cliffbraun/BarBuddy/data_analysis/curl orientation.png

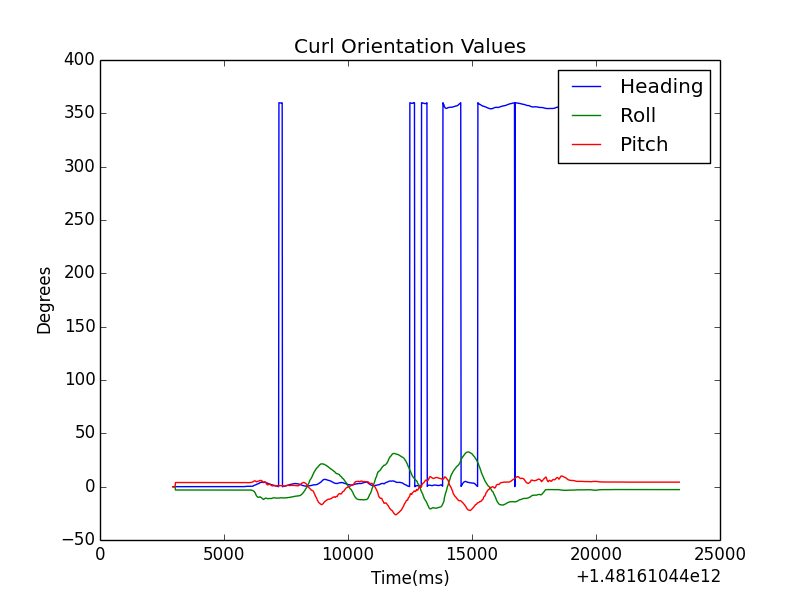
data_analysis/curl orientation.png
