cliffbraun/BarBuddy/data_analysis/curl orientation_trimmed.png

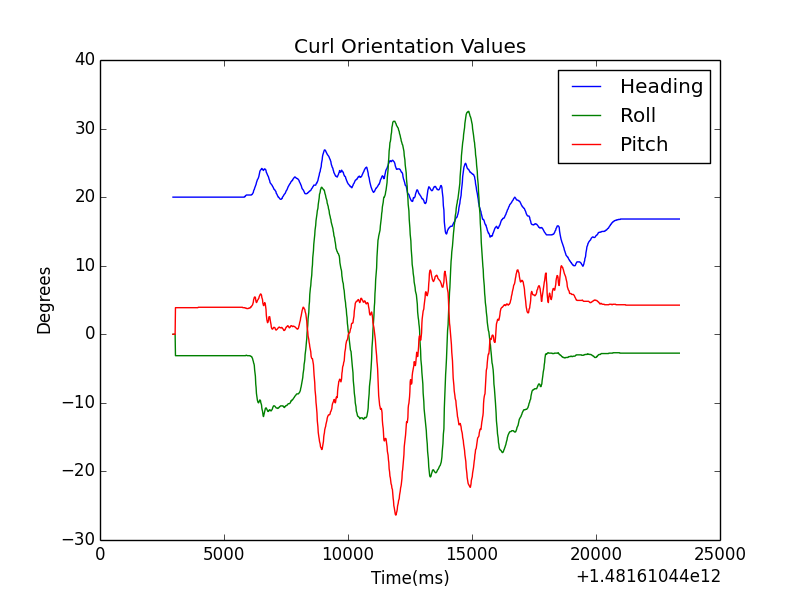
data_analysis/curl orientation_trimmed.png
