cliffbraun/BarBuddy/data_analysis/toomuchdata.png

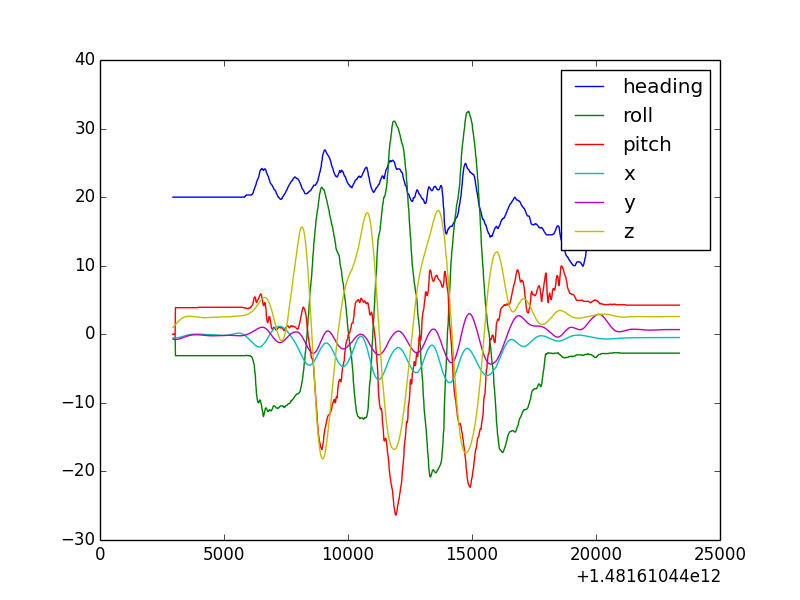
data_analysis/toomuchdata.png
