cliffbraun/BarBuddy/report/warmup.png

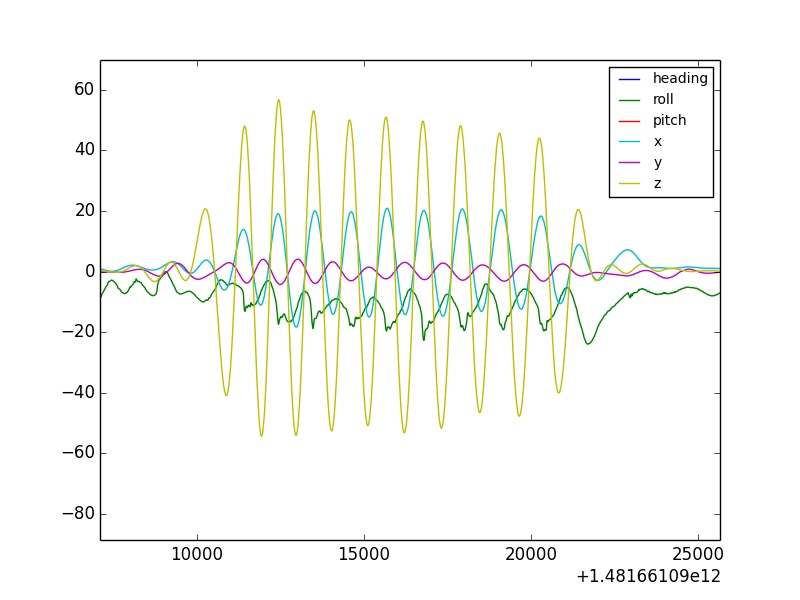
report/warmup.png
