cliffbraun/BarBuddy/report/figures/BarBuddy_design.pdf

## Bar Buddy Task Diagram Cliff Braun

27-11-16

Notes:
Priority 0 is Highest
*Current hardware does not include button

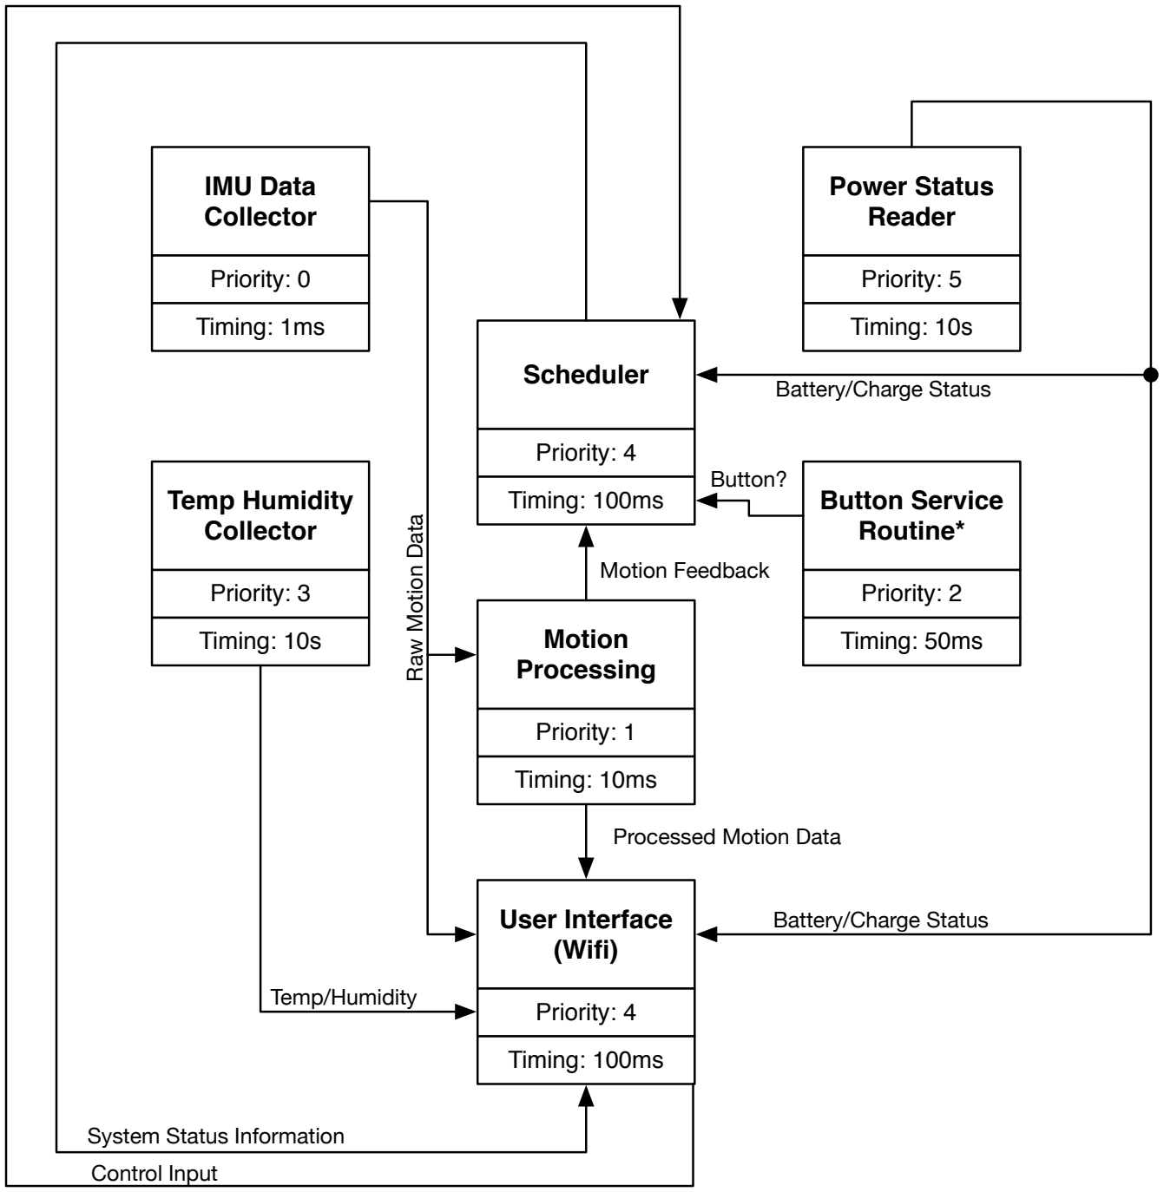
[picture p19: figure]
IMU Data Collector; Priority: 0; Timing: 1ms; Temp Humidity Collector; Priority: 3; Timing: 10s; User Interface (Wifi); Priority: 4; Timing: 100ms; Power Status Reader; Priority: 5; Scheduler; Button Service; Routine*; Priority: 2; Motion; Timing: 50ms; Processing; Priority: 1; Timing: 10ms; Battery/Charge Status; Temp/Humidity Raw Motion Data; Control Input; System Status Information; Processed Motion Data; Motion Feedback; Button?

## Bar Buddy Scheduler States Cliff Braun

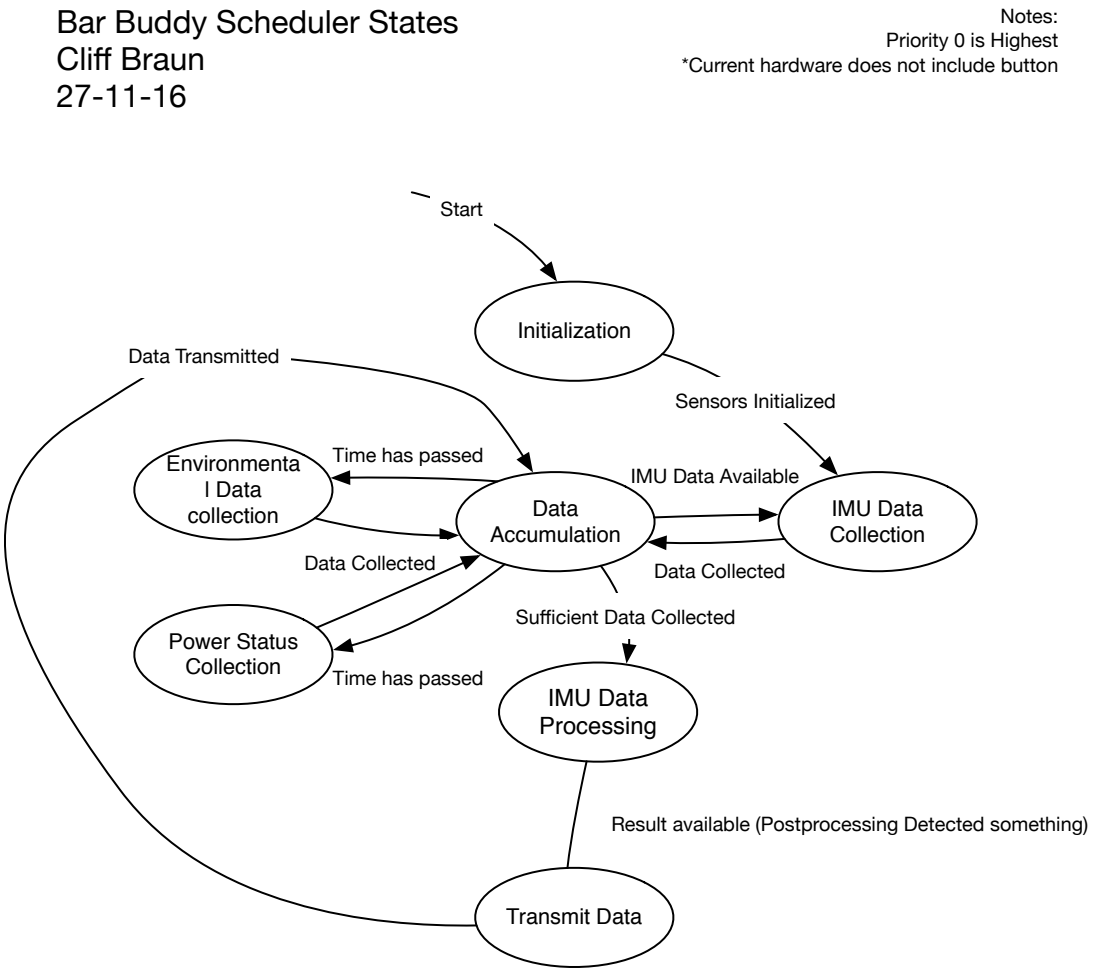
[picture p20: page 2]
Initialization; IMU Data Collection; IMU Data Processing; Power Status Collection; Transmit Data; Data Accumulation; Environmenta l Data collection; Notes:; Start; Sensors Initialized; Data Collected; Data Transmitted

Priority 0 is Highest

*Current hardware does not include button

Time has passed

IMU Data Available

Sufficient Data Collected

Result available (Postprocessing Detected something)
