cliffbraun/BarBuddy/board_cad/barbuddy_4layer.brd

## EAGLE design board_cad/barbuddy_4layer.brd (2016-12-14)

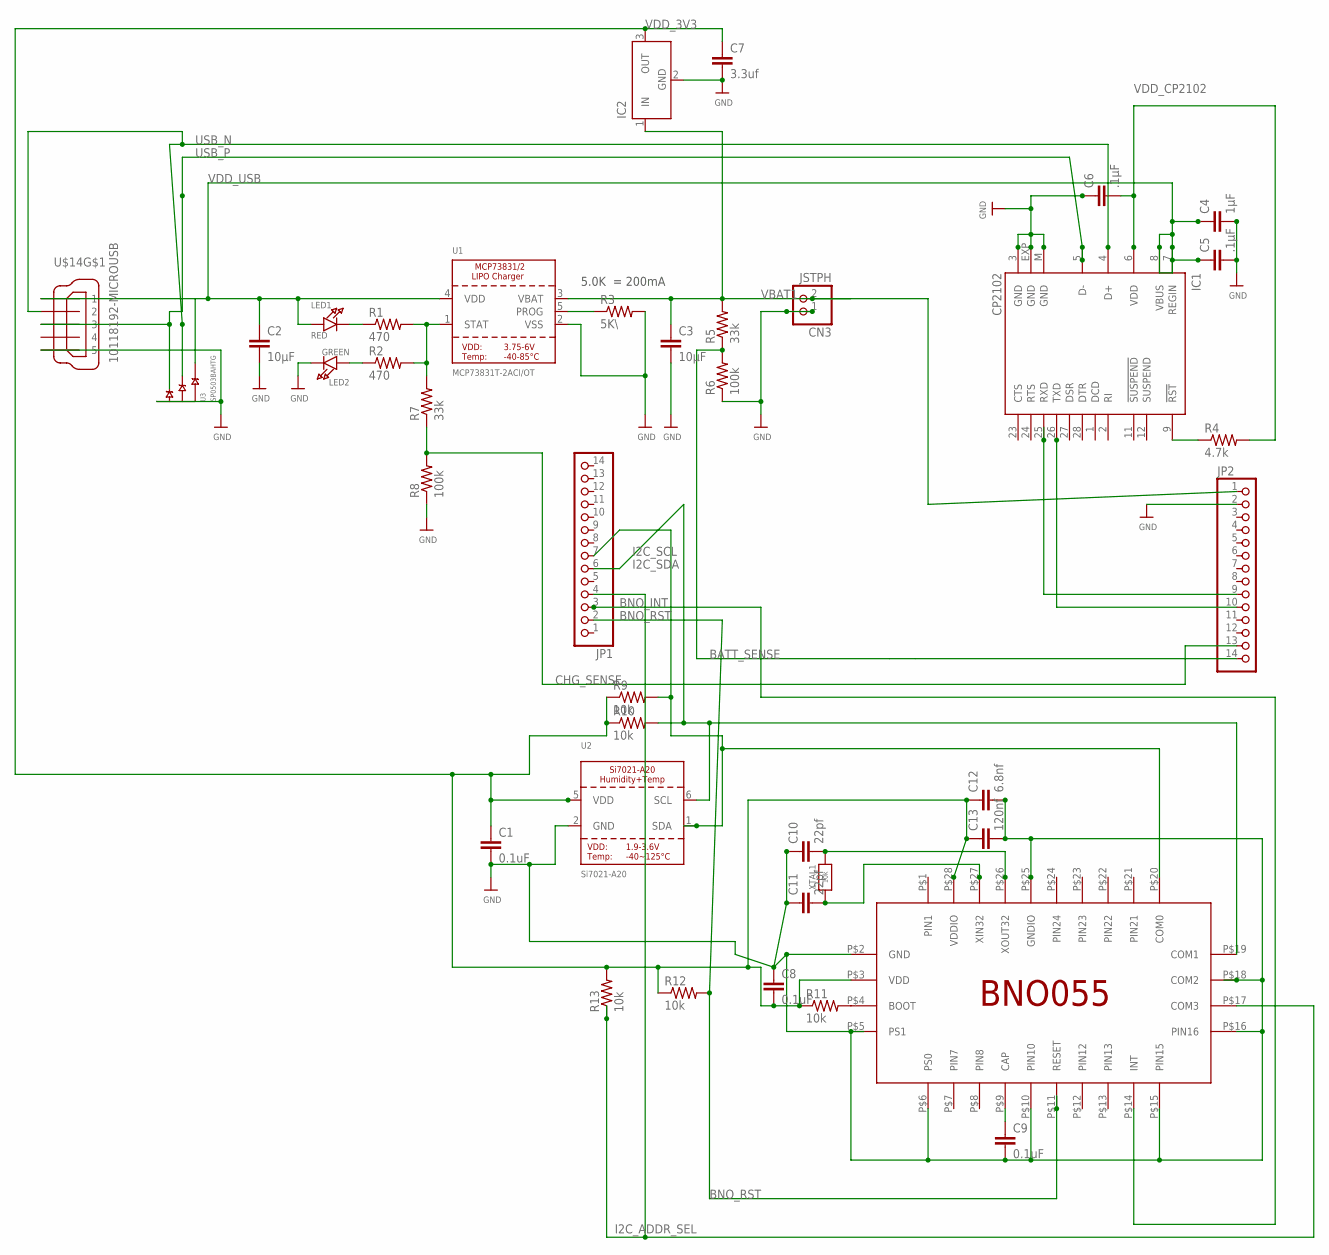
[picture p21: schematic barbuddy_4layer.sch]

Parts:
BNO055: BNO055; LGA-28
C1, C8, C9: 0.1uF; C0402
C2, C3: 10µF; C0402
C4: 1µF; C0402
C5, C6: .1µF; C0402
C7: 3.3uf; C0402
C10, C11: 22pf; C0402
C12: 6.8nf; C0402
C13: 120nf; C0402
CN3: JSTPH; JSTPH2
IC1: CP2102; MLP28
IC2: LT1129CST5; SOT223
JP1, JP2: PINHD-1X14; 1X14
LED1: RED; CHIPLED_0805_NOOUTLINE
LED2: GREEN; CHIPLED_0805_NOOUTLINE
R1, R2: 470; R0402
R3: 5K\; R0402
R4: 4.7k; R0402
R5, R7: 33k; R0402
R6, R8: 100k; R0402
R9, R10, R11, R12, R13: 10k; R0402
U1: MCP73831T-2ACI/OT; SOT23-5
U2: Si7021-A20; DFN6_3X3_SI
U3: SP0503BAHTG; SOT143
U$14: 10118192-MICROUSB; MICROUSB-SMT
XTAL1: 10k; 0805-NO

Connections:
BATT_SENSE: JP2.14, R5.1, R6.2
BNO_CAP: BNO055.P$9 (CAP), C9.1
BNO_INT: BNO055.P$14 (INT), JP1.3
BNO_RST: BNO055.P$11 (RESET), JP1.2, R12.2
CHG_PROG: R3.1, U1.5 (PROG)
CHG_SENSE: JP2.13, R7.1, R8.2
CHG_STATUS: R1.2, R2.2, R7.2, U1.1 (STAT)
CP2102_RST: IC1.9 (!RST), R4.1
GND: BNO055.P$2 (GND), BNO055.P$5 (PS1), BNO055.P$6 (PS0), BNO055.P$10 (PIN10), BNO055.P$15 (PIN15), BNO055.P$16 (PIN16), BNO055.P$18 (COM2), BNO055.P$25 (GNDIO), C1.2, C2.2, C3.2, C4.2, C5.2, C6.1, C7.2, C8.1, C9.2, C10.1, C11.1, C12.2, C13.2, CN3.1, IC1.3 (GND), IC1.EXP (GND), IC1.M (GND), IC2.2 (GND), IC2.4 (GND), JP2.2, LED2.C, R3.2, R6.1, R8.1, U1.2 (VSS), U2.2 (GND), U3.1 (GND), U$14.P$5 (5)
I2C_ADDR_SEL: BNO055.P$17 (COM3), JP1.4, R13.1
I2C_SCL: BNO055.P$19 (COM1), JP1.6, R10.2, U2.6 (SCL)
I2C_SDA: BNO055.P$20 (COM0), JP1.7, R9.2, U2.1 (SDA)
unnamed: LED1.C, R1.1
unnamed: BNO055.P$4 (BOOT), R11.2
unnamed: LED2.A, R2.1
UART0_RX: IC1.26 (TXD), JP2.10
UART0_TX: IC1.25 (RXD), JP2.9
USB_N: IC1.4 (D+), U3.3 (B), U$14.P$2 (2)
USB_P: IC1.5 (D-), U3.2 (A), U$14.P$3 (3)
VBAT1: C3.1, CN3.2, IC2.1 (IN), JP2.1, R5.2, U1.3 (VBAT)
VDD_3V3: BNO055.P$3 (VDD), BNO055.P$28 (VDDIO), C1.1, C7.1, C8.2, C12.1, C13.1, IC2.3 (OUT), R9.1, R10.1, R11.1, R12.1, R13.2, U2.5 (VDD)
VDD_CP2102: C6.2, IC1.6 (VDD), R4.2
VDD_USB: C2.1, C4.1, C5.1, IC1.7 (REGIN), IC1.8 (VBUS), LED1.A, U1.4 (VDD), U3.4 (C), U$14.P$1 (1)
X_IN: BNO055.P$27 (XIN32), C11.2, XTAL1.1
X_OUT: BNO055.P$26 (XOUT32), C10.2, XTAL1.2

Notes on the sheet:
5.0K = 200mA

Board: 4 copper layers, 39 parts (16 on the bottom side), 25 nets, no tracks yet.
