cliffbraun/BarBuddy/board_cad/barbuddy_SIngle.brd

## EAGLE design board_cad/barbuddy_SIngle.brd (2016-11-29)

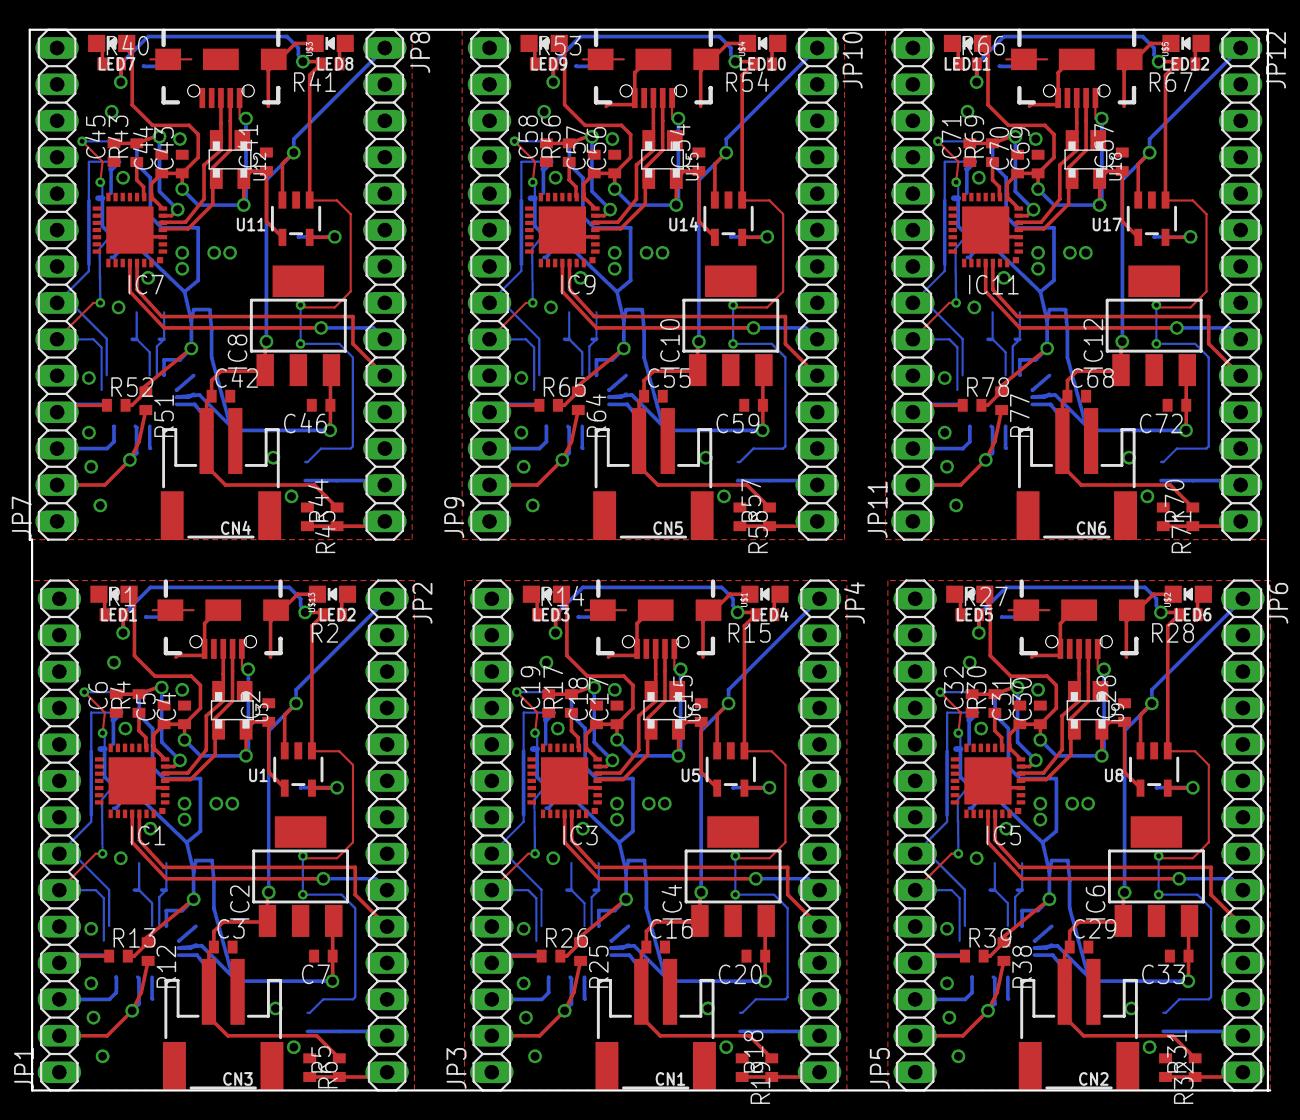
[picture p22: board barbuddy_SIngle.brd from above]

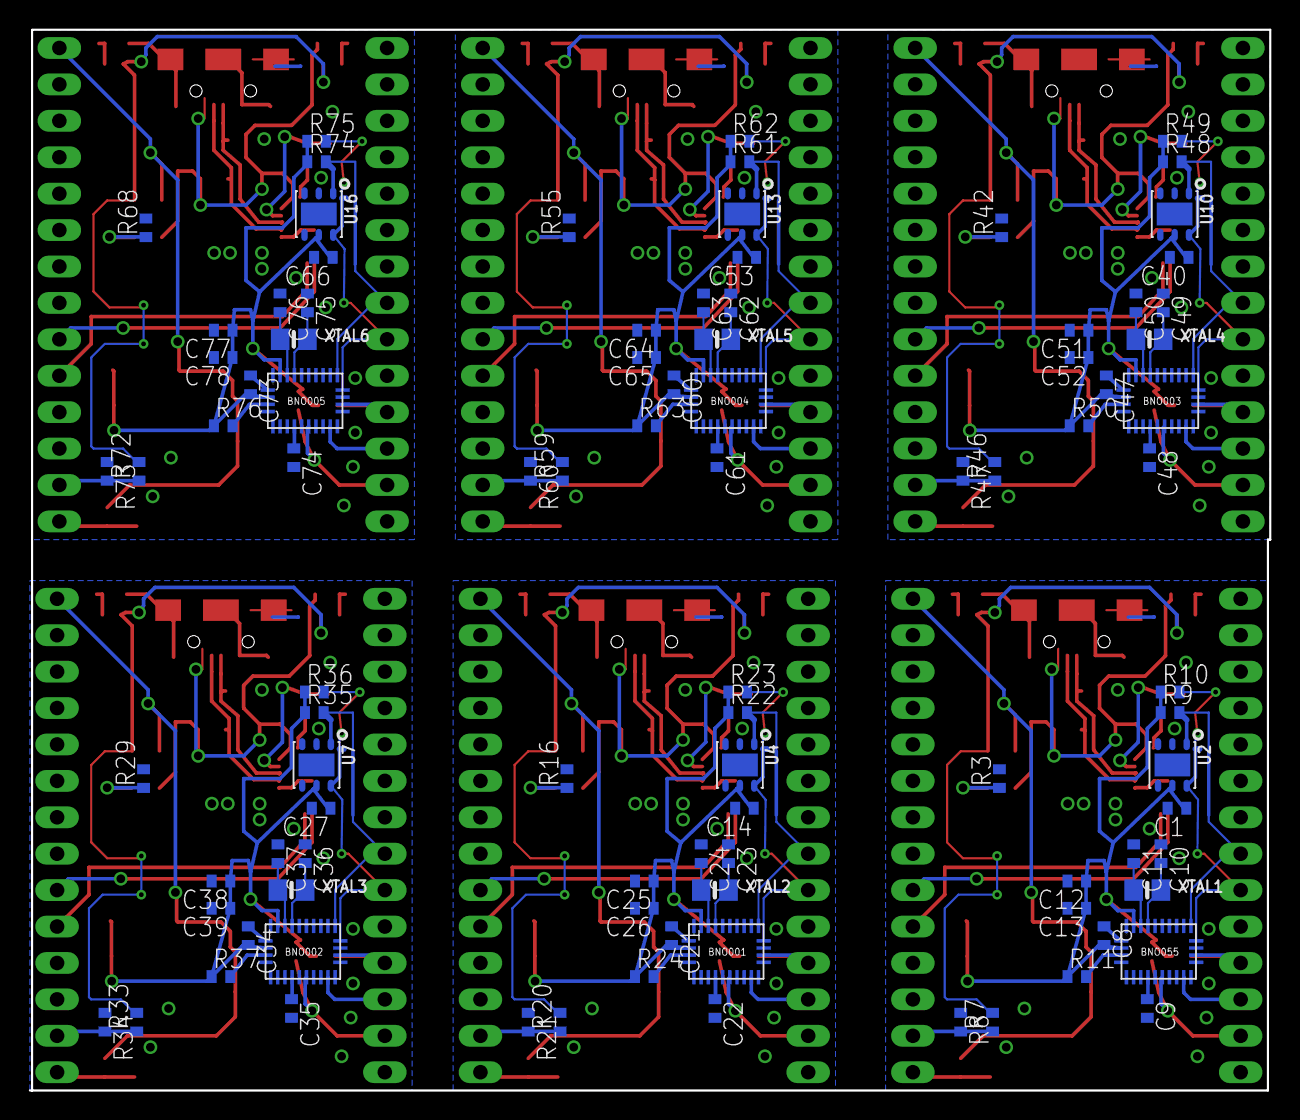
[picture p23: board barbuddy_SIngle.brd from below]

Board: 2 copper layers, 86.4 x 74.0 mm, 234 parts (96 on the bottom side), 150 nets.

Parts:
BNO001, BNO002, BNO003, BNO004, BNO005, BNO055: BNO055; LGA-28
C1, C8, C9, C14, C21, C22, C27, C34, C35, C40, C47, C48, C53, C60, C61, C66, C73, C74: 0.1uF; C0402
C2, C3, C15, C16, C28, C29, C41, C42, C54, C55, C67, C68: 10µF; C0402
C4, C17, C30, C43, C56, C69: 1µF; C0402
C5, C6, C18, C19, C31, C32, C44, C45, C57, C58, C70, C71: .1µF; C0402
C7, C20, C33, C46, C59, C72: 3.3uf; C0402
C10, C11, C23, C24, C36, C37, C49, C50, C62, C63, C75, C76: 22pf; C0402
C12, C25, C38, C51, C64, C77: 6.8nf; C0402
C13, C26, C39, C52, C65, C78: 120nf; C0402
CN1, CN2, CN3, CN4, CN5, CN6: JSTPH; JSTPH2
IC1, IC3, IC5, IC7, IC9, IC11: CP2102; MLP28
IC2, IC4, IC6, IC8, IC10, IC12: SOT223
JP1, JP2, JP3, JP4, JP5, JP6, JP7, JP8, JP9, JP10, JP11, JP12: 1X14
LED1, LED3, LED5, LED7, LED9, LED11: RED; CHIPLED_0805_NOOUTLINE
LED2, LED4, LED6, LED8, LED10, LED12: GREEN; CHIPLED_0805_NOOUTLINE
R1, R2, R14, R15, R27, R28, R40, R41, R53, R54, R66, R67: 470; R0402
R3, R16, R29, R42, R55, R68: 5K\; R0402
R4, R17, R30, R43, R56, R69: 4.7k; R0402
R5, R7, R18, R20, R31, R33, R44, R46, R57, R59, R70, R72: 33k; R0402
R6, R8, R19, R21, R32, R34, R45, R47, R58, R60, R71, R73: 100k; R0402
R9, R10, R11, R12, R13, R22, R23, R24, R25, R26, R35, R36, R37, R38, R39, R48, R49, R50, R51, R52, R61, R62, R63, R64, R65, R74, R75, R76, R77, R78: 10k; R0402
U1, U5, U8, U11, U14, U17: MCP73831T-2ACI/OT; SOT23-5
U2, U4, U7, U10, U13, U16: Si7021-A20; DFN6_3X3_SI
U3, U6, U9, U12, U15, U18: SP0503BAHTG; SOT143
U$1, U$2, U$3, U$4, U$5, U$13: USB-AB-MICRO-SMD_V02_BOSS
XTAL1, XTAL2, XTAL3, XTAL4, XTAL5, XTAL6: 10k; 0805-NO

Connections:
BATT_SENSE: JP2.14, R5.1, R6.2
BATT_SENSE1: JP4.14, R18.1, R19.2
BATT_SENSE2: JP6.14, R31.1, R32.2
BATT_SENSE3: JP8.14, R44.1, R45.2
BATT_SENSE4: JP10.14, R57.1, R58.2
BATT_SENSE5: JP12.14, R70.1, R71.2
BNO_CAP: BNO055.P$9, C9.1
BNO_CAP1: BNO001.P$9, C22.1
BNO_CAP2: BNO002.P$9, C35.1
BNO_CAP3: BNO003.P$9, C48.1
BNO_CAP4: BNO004.P$9, C61.1
BNO_CAP5: BNO005.P$9, C74.1
BNO_INT: BNO055.P$14, JP1.3
BNO_INT1: BNO001.P$14, JP3.3
BNO_INT2: BNO002.P$14, JP5.3
BNO_INT3: BNO003.P$14, JP7.3
BNO_INT4: BNO004.P$14, JP9.3
BNO_INT5: BNO005.P$14, JP11.3
BNO_RST: BNO055.P$11, JP1.2, R12.2
BNO_RST1: BNO001.P$11, JP3.2, R25.2
BNO_RST2: BNO002.P$11, JP5.2, R38.2
BNO_RST3: BNO003.P$11, JP7.2, R51.2
BNO_RST4: BNO004.P$11, JP9.2, R64.2
BNO_RST5: BNO005.P$11, JP11.2, R77.2
CHG_PROG: R3.1, U1.5
CHG_PROG1: R16.1, U5.5
CHG_PROG2: R29.1, U8.5
CHG_PROG3: R42.1, U11.5
CHG_PROG4: R55.1, U14.5
CHG_PROG5: R68.1, U17.5
CHG_SENSE: JP2.13, R7.1, R8.2
CHG_SENSE1: JP4.13, R20.1, R21.2
CHG_SENSE2: JP6.13, R33.1, R34.2
CHG_SENSE3: JP8.13, R46.1, R47.2
CHG_SENSE4: JP10.13, R59.1, R60.2
CHG_SENSE5: JP12.13, R72.1, R73.2
CHG_STATUS: R1.2, R2.2, R7.2, U1.1
CHG_STATUS1: R14.2, R15.2, R20.2, U5.1
CHG_STATUS2: R27.2, R28.2, R33.2, U8.1
CHG_STATUS3: R40.2, R41.2, R46.2, U11.1
CHG_STATUS4: R53.2, R54.2, R59.2, U14.1
CHG_STATUS5: R66.2, R67.2, R72.2, U17.1
CP2102_RST: IC1.9, R4.1
CP2102_RST1: IC3.9, R17.1
CP2102_RST2: IC5.9, R30.1
CP2102_RST3: IC7.9, R43.1
CP2102_RST4: IC9.9, R56.1
CP2102_RST5: IC11.9, R69.1
GND: BNO055.P$2, BNO055.P$5, BNO055.P$6, BNO055.P$10, BNO055.P$15, BNO055.P$16, BNO055.P$18, BNO055.P$25, C1.2, C2.2, C3.2, C4.2, C5.2, C6.1, C7.2, C8.1, C9.2, C10.1, C11.1, C12.2, C13.2, CN3.1, IC1.3, IC1.EXP, IC1.M, IC2.2, IC2.4, JP2.2, LED2.C, R3.2, R6.1, R8.1, U1.2, U2.2, U3.1
GND2: BNO001.P$2, BNO001.P$5, BNO001.P$6, BNO001.P$10, BNO001.P$15, BNO001.P$16, BNO001.P$18, BNO001.P$25, C14.2, C15.2, C16.2, C17.2, C18.2, C19.1, C20.2, C21.1, C22.2, C23.1, C24.1, C25.2, C26.2, CN1.1, IC3.3, IC3.EXP, IC3.M, IC4.2, IC4.4, JP4.2, LED4.C, R16.2, R19.1, R21.1, U4.2, U5.2, U6.1
GND4: BNO002.P$2, BNO002.P$5, BNO002.P$6, BNO002.P$10, BNO002.P$15, BNO002.P$16, BNO002.P$18, BNO002.P$25, C27.2, C28.2, C29.2, C30.2, C31.2, C32.1, C33.2, C34.1, C35.2, C36.1, C37.1, C38.2, C39.2, CN2.1, IC5.3, IC5.EXP, IC5.M, IC6.2, IC6.4, JP6.2, LED6.C, R29.2, R32.1, R34.1, U7.2, U8.2, U9.1
GND6: BNO003.P$2, BNO003.P$5, BNO003.P$6, BNO003.P$10, BNO003.P$15, BNO003.P$16, BNO003.P$18, BNO003.P$25, C40.2, C41.2, C42.2, C43.2, C44.2, C45.1, C46.2, C47.1, C48.2, C49.1, C50.1, C51.2, C52.2, CN4.1, IC7.3, IC7.EXP, IC7.M, IC8.2, IC8.4, JP8.2, LED8.C, R42.2, R45.1, R47.1, U10.2, U11.2, U12.1
GND8: BNO004.P$2, BNO004.P$5, BNO004.P$6, BNO004.P$10, BNO004.P$15, BNO004.P$16, BNO004.P$18, BNO004.P$25, C53.2, C54.2, C55.2, C56.2, C57.2, C58.1, C59.2, C60.1, C61.2, C62.1, C63.1, C64.2, C65.2, CN5.1, IC9.3, IC9.EXP, IC9.M, IC10.2, IC10.4, JP10.2, LED10.C, R55.2, R58.1, R60.1, U13.2, U14.2, U15.1
GND10: BNO005.P$2, BNO005.P$5, BNO005.P$6, BNO005.P$10, BNO005.P$15, BNO005.P$16, BNO005.P$18, BNO005.P$25, C66.2, C67.2, C68.2, C69.2, C70.2, C71.1, C72.2, C73.1, C74.2, C75.1, C76.1, C77.2, C78.2, CN6.1, IC11.3, IC11.EXP, IC11.M, IC12.2, IC12.4, JP12.2, LED12.C, R68.2, R71.1, R73.1, U16.2, U17.2, U18.1
I2C_ADDR_SEL: BNO055.P$17, JP1.4, R13.1
I2C_ADDR_SEL1: BNO001.P$17, JP3.4, R26.1
I2C_ADDR_SEL2: BNO002.P$17, JP5.4, R39.1
I2C_ADDR_SEL3: BNO003.P$17, JP7.4, R52.1
I2C_ADDR_SEL4: BNO004.P$17, JP9.4, R65.1
I2C_ADDR_SEL5: BNO005.P$17, JP11.4, R78.1
I2C_SCL: BNO055.P$19, JP1.6, R10.2, U2.6
I2C_SCL1: BNO001.P$19, JP3.6, R23.2, U4.6
I2C_SCL2: BNO002.P$19, JP5.6, R36.2, U7.6
I2C_SCL3: BNO003.P$19, JP7.6, R49.2, U10.6
I2C_SCL4: BNO004.P$19, JP9.6, R62.2, U13.6
I2C_SCL5: BNO005.P$19, JP11.6, R75.2, U16.6
I2C_SDA: BNO055.P$20, JP1.7, R9.2, U2.1
I2C_SDA1: BNO001.P$20, JP3.7, R22.2, U4.1
I2C_SDA2: BNO002.P$20, JP5.7, R35.2, U7.1
I2C_SDA3: BNO003.P$20, JP7.7, R48.2, U10.1
I2C_SDA4: BNO004.P$20, JP9.7, R61.2, U13.1
I2C_SDA5: BNO005.P$20, JP11.7, R74.2, U16.1
unnamed: LED1.C, R1.1
unnamed: LED3.C, R14.1
unnamed: BNO055.P$4, R11.2
unnamed: LED4.A, R15.1
unnamed: BNO001.P$4, R24.2
unnamed: LED2.A, R2.1
unnamed: LED5.C, R27.1
unnamed: LED6.A, R28.1
unnamed: BNO002.P$4, R37.2
unnamed: LED7.C, R40.1
unnamed: LED8.A, R41.1
unnamed: BNO003.P$4, R50.2
unnamed: LED9.C, R53.1
unnamed: LED10.A, R54.1
unnamed: BNO004.P$4, R63.2
unnamed: LED11.C, R66.1
unnamed: LED12.A, R67.1
unnamed: BNO005.P$4, R76.2
UART0_RX: IC1.26, JP2.10
UART0_RX1: IC3.26, JP4.10
UART0_RX2: IC5.26, JP6.10
UART0_RX3: IC7.26, JP8.10
UART0_RX4: IC9.26, JP10.10
UART0_RX5: IC11.26, JP12.10
UART0_TX: IC1.25, JP2.9
UART0_TX1: IC3.25, JP4.9
UART0_TX2: IC5.25, JP6.9
UART0_TX3: IC7.25, JP8.9
UART0_TX4: IC9.25, JP10.9
UART0_TX5: IC11.25, JP12.9
USB_N: IC1.4, U3.3
USB_N1: IC3.4, U6.3
USB_N2: IC5.4, U9.3
USB_N3: IC7.4, U12.3
USB_N4: IC9.4, U15.3
USB_N5: IC11.4, U18.3
USB_P: IC1.5, U3.2
USB_P1: IC3.5, U6.2
USB_P2: IC5.5, U9.2
USB_P3: IC7.5, U12.2
USB_P4: IC9.5, U15.2
USB_P5: IC11.5, U18.2
VBAT1: C3.1, CN3.2, IC2.1, JP2.1, R5.2, U1.3
VBAT2: C16.1, CN1.2, IC4.1, JP4.1, R18.2, U5.3
VBAT3: C29.1, CN2.2, IC6.1, JP6.1, R31.2, U8.3
VBAT4: C42.1, CN4.2, IC8.1, JP8.1, R44.2, U11.3
VBAT5: C55.1, CN5.2, IC10.1, JP10.1, R57.2, U14.3
VBAT6: C68.1, CN6.2, IC12.1, JP12.1, R70.2, U17.3
VDD_3V1: BNO001.P$3, BNO001.P$28, C14.1, C20.1, C21.2, C25.1, C26.1, IC4.3, R22.1, R23.1, R24.1, R25.1, R26.2, U4.5
VDD_3V2: BNO002.P$3, BNO002.P$28, C27.1, C33.1, C34.2, C38.1, C39.1, IC6.3, R35.1, R36.1, R37.1, R38.1, R39.2, U7.5
VDD_3V3: BNO055.P$3, BNO055.P$28, C1.1, C7.1, C8.2, C12.1, C13.1, IC2.3, R9.1, R10.1, R11.1, R12.1, R13.2, U2.5
VDD_3V4: BNO003.P$3, BNO003.P$28, C40.1, C46.1, C47.2, C51.1, C52.1, IC8.3, R48.1, R49.1, R50.1, R51.1, R52.2, U10.5
VDD_3V5: BNO004.P$3, BNO004.P$28, C53.1, C59.1, C60.2, C64.1, C65.1, IC10.3, R61.1, R62.1, R63.1, R64.1, R65.2, U13.5
VDD_3V6: BNO005.P$3, BNO005.P$28, C66.1, C72.1, C73.2, C77.1, C78.1, IC12.3, R74.1, R75.1, R76.1, R77.1, R78.2, U16.5
VDD_CP1: C19.2, IC3.6, R17.2
VDD_CP2: C32.2, IC5.6, R30.2
VDD_CP3: C45.2, IC7.6, R43.2
VDD_CP4: C58.2, IC9.6, R56.2
VDD_CP5: C71.2, IC11.6, R69.2
VDD_CP2102: C6.2, IC1.6, R4.2
VDD_USB: C2.1, C4.1, C5.1, IC1.7, IC1.8, LED1.A, U1.4, U3.4, U$13.VBUS1
VDD_USB1: C15.1, C17.1, C18.1, IC3.7, IC3.8, LED3.A, U5.4, U6.4, U$1.VBUS1
VDD_USB2: C28.1, C30.1, C31.1, IC5.7, IC5.8, LED5.A, U8.4, U9.4, U$2.VBUS1
VDD_USB3: C41.1, C43.1, C44.1, IC7.7, IC7.8, LED7.A, U11.4, U12.4, U$3.VBUS1
VDD_USB4: C54.1, C56.1, C57.1, IC9.7, IC9.8, LED9.A, U14.4, U15.4, U$4.VBUS1
VDD_USB5: C67.1, C69.1, C70.1, IC11.7, IC11.8, LED11.A, U17.4, U18.4, U$5.VBUS1
X_IN: BNO055.P$27, C11.2, XTAL1.1
X_IN1: BNO001.P$27, C24.2, XTAL2.1
X_IN2: BNO002.P$27, C37.2, XTAL3.1
X_IN3: BNO003.P$27, C50.2, XTAL4.1
X_IN4: BNO004.P$27, C63.2, XTAL5.1
X_IN5: BNO005.P$27, C76.2, XTAL6.1
X_OUT: BNO055.P$26, C10.2, XTAL1.2
X_OUT1: BNO001.P$26, C23.2, XTAL2.2
X_OUT2: BNO002.P$26, C36.2, XTAL3.2
X_OUT3: BNO003.P$26, C49.2, XTAL4.2
X_OUT4: BNO004.P$26, C62.2, XTAL5.2
X_OUT5: BNO005.P$26, C75.2, XTAL6.2
